lindekai/FlipFlatPanel/(commit log)

2026-03-30 Add schematic diagram link to README
    Added a link to the schematic diagram in the README.
2026-05-01 new firmware, ASCOM driver, controller app, installer scripts)
2026-05-05 New V3 Version
    // Neu in v3.0:
    // - Einstellbare Servo-Endpunkte (Open/Close Position)
    // - Einstellbare Bewegungsgeschwindigkeit (1-10)
    // - SoftClose-Modus (langsam starten/stoppen)
    // - EEPROM-Speicherung aller Einstellungen
    // - Neue Befehle: SETOPEN, SETCLOSE, SETSPEED, SETSOFTCLOSE
2026-05-05 New V3 ino
    Neu in v3.0:
    - Einstellbare Servo-Endpunkte (Open/Close Position)
    - Einstellbare Bewegungsgeschwindigkeit (1-10)
    - SoftClose-Modus (langsam starten/stoppen)
    - EEPROM-Speicherung aller Einstellungen
    - Neue Befehle: SETOPEN, SETCLOSE, SETSPEED, SETSOFTCLOSE
2026-05-06 Add files via upload
    added PCB Gerber file
2026-05-06 Add initial information about PCB status
2026-05-06 Rename Bildschirmfoto 2026-05-06 um 14.54.31.png to PCB_Image
2026-05-06 Rename SMD Platine Flatpanel_arduino nano v19_2026-05-06.zip to gerberfile
